houseofnorth/neonfade/Neonfade v422 bottom.png

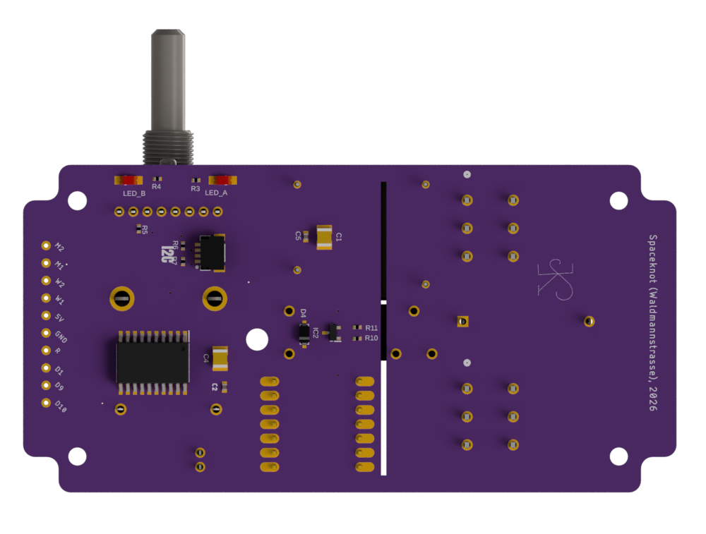
Neonfade v422 bottom.png
