houseofnorth/neonfade/Specs/ALPS-RK168-100KBX2-Pinout.jpg

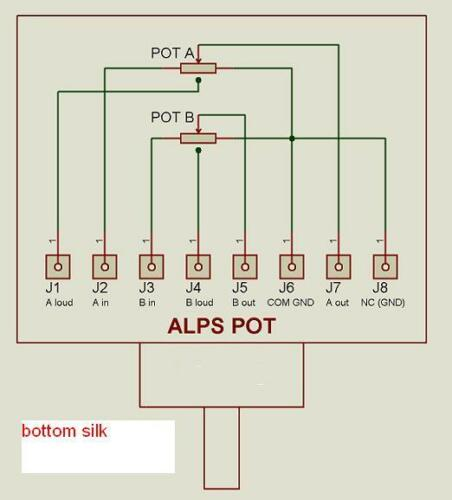
Specs/ALPS-RK168-100KBX2-Pinout.jpg
