houseofnorth/neonfade/Specs/XIAO ESP32 C3 Pin Map.png

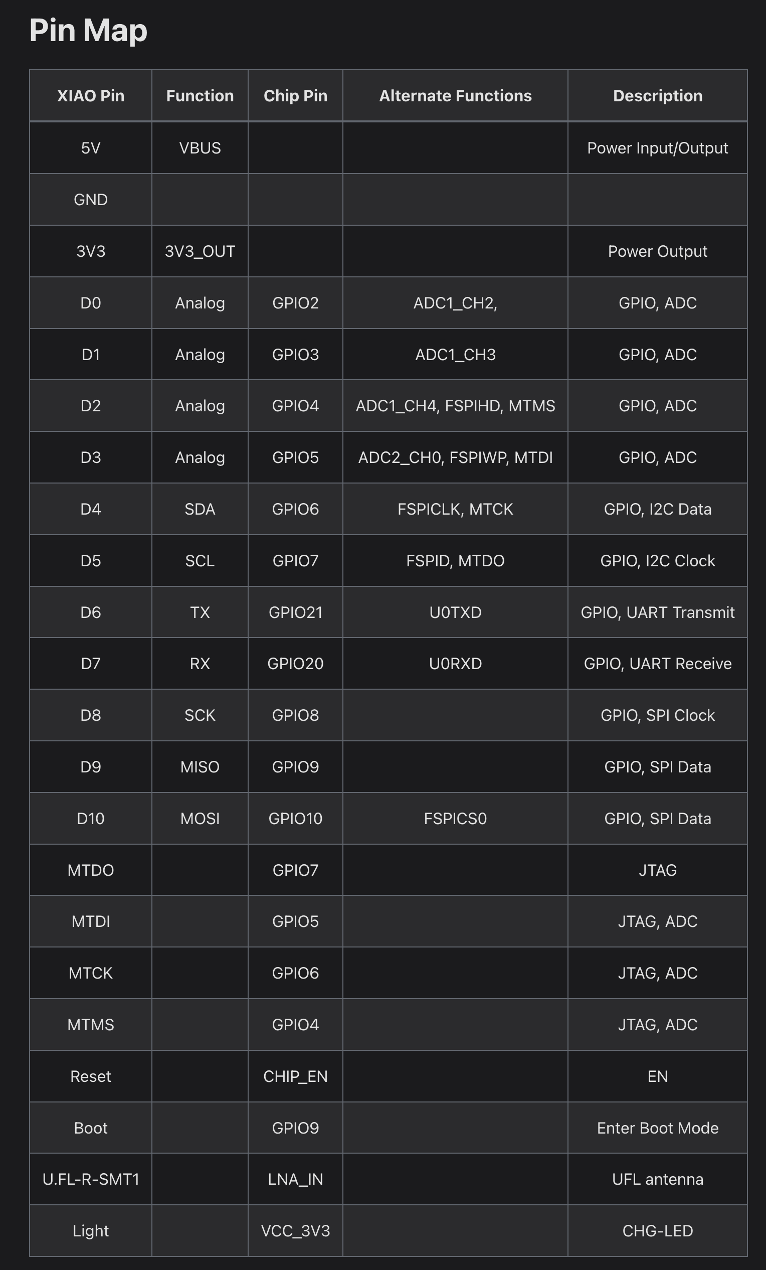
Specs/XIAO ESP32 C3 Pin Map.png
