houseofnorth/neonfade/Neon_Fader_V2_v376.sch

## EAGLE design Neon_Fader_V2_v376.sch (2026-05-29)

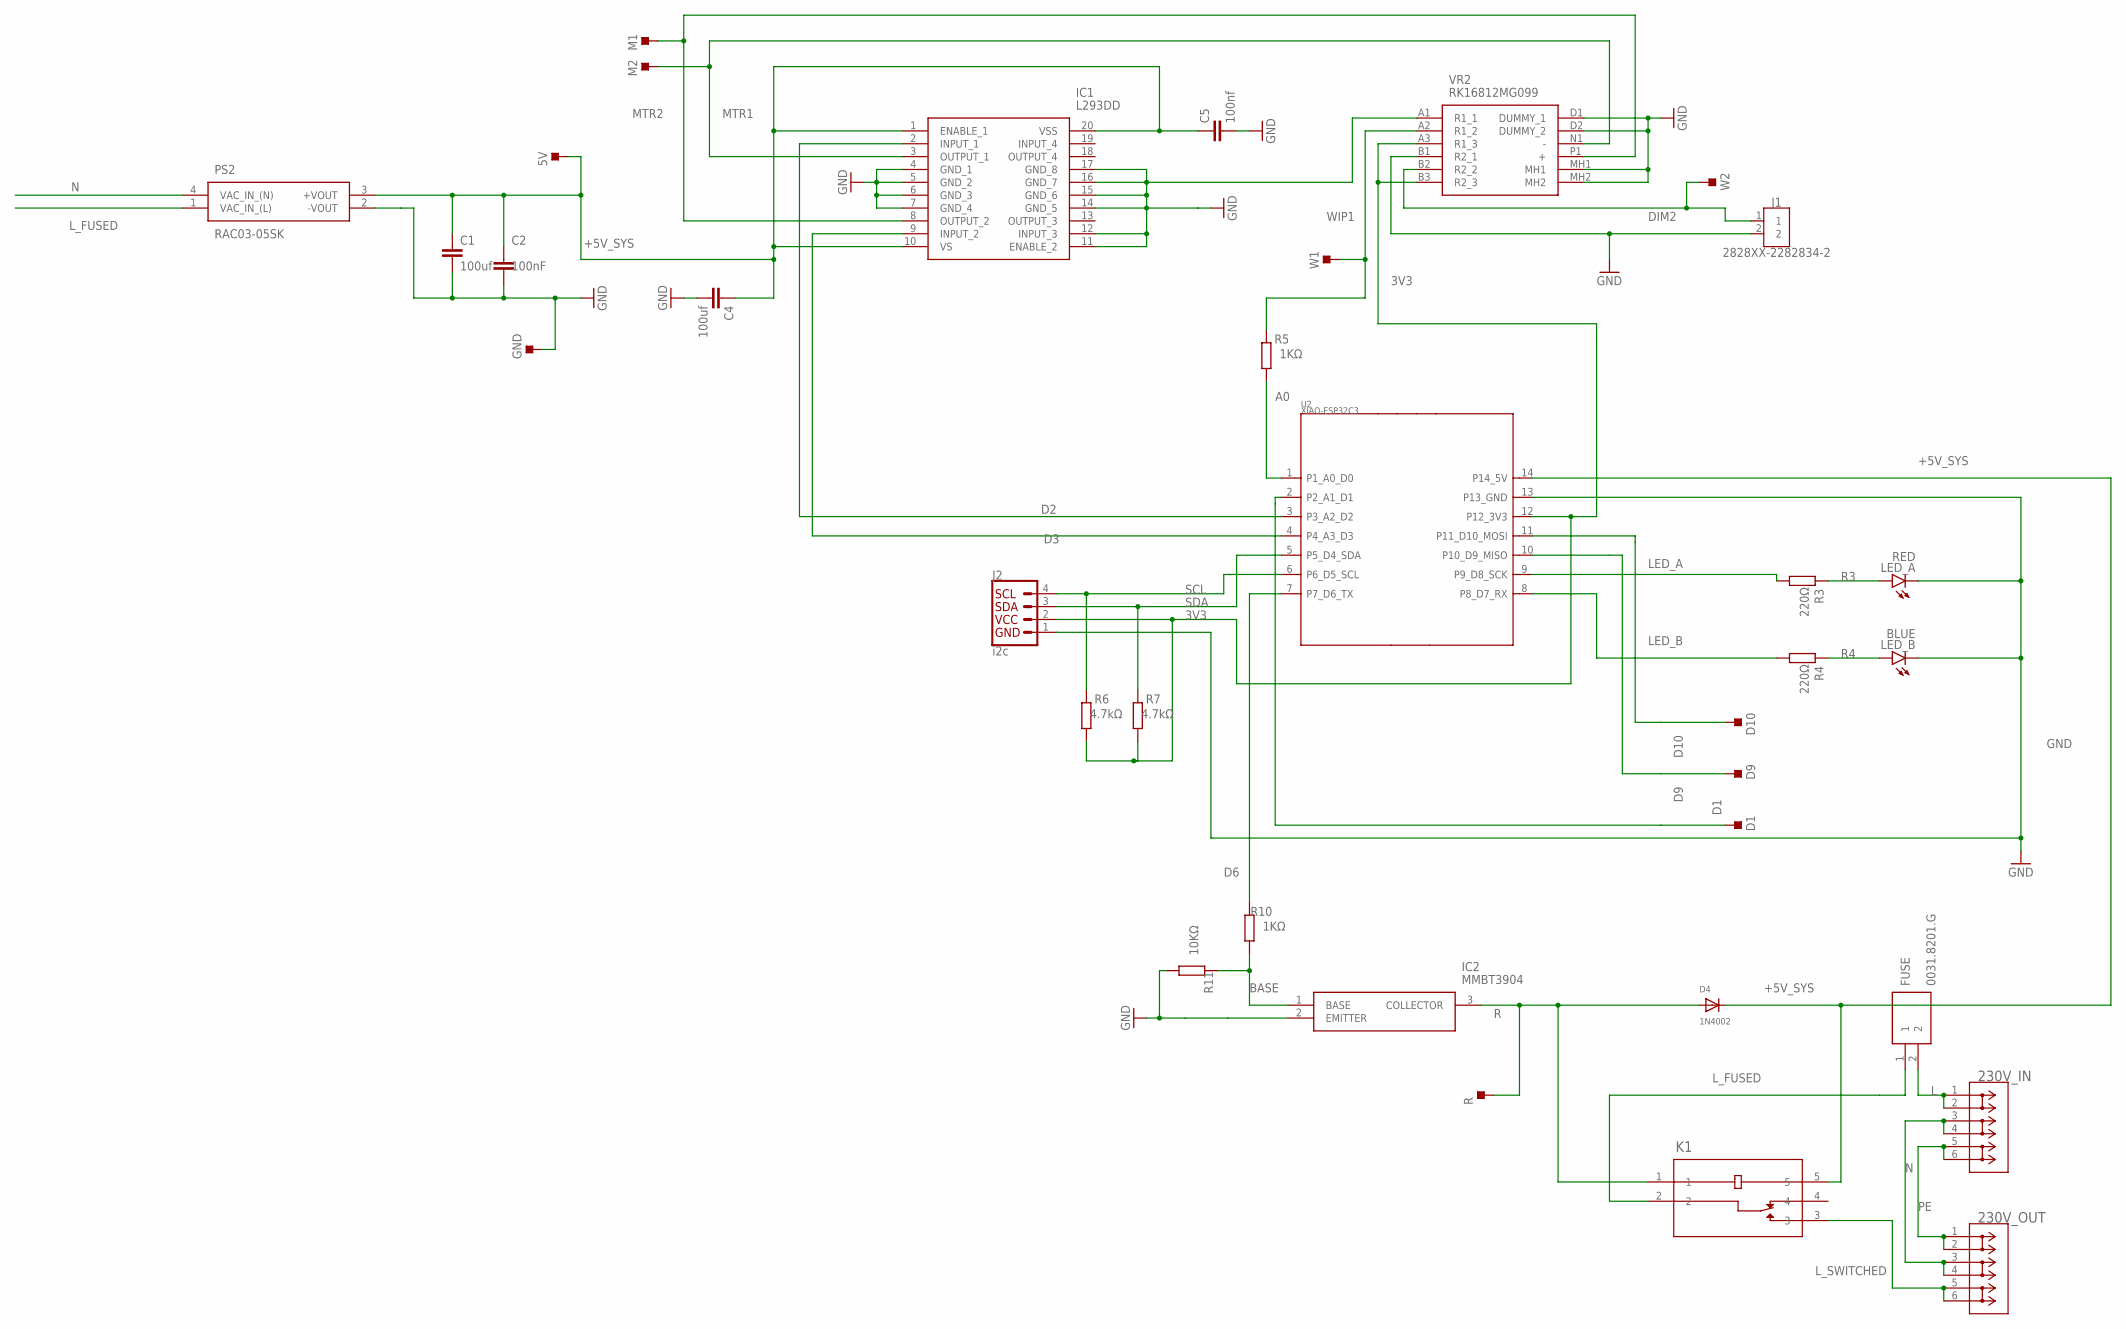
[picture p5: schematic Neon_Fader_V2_v376.sch]

Parts:
5V: TESTPOINT_TPS-PAD-036; TESTPOINT_PAD-036
230V_IN, 230V_OUT: 2604-1103CONN3_2604-1103_WAG; CONN3_2604-1103_WAG
C1, C4: 100uf; C1210
C2: 100nF; C0402
C5: 100nf; C0402
D1, D9, D10: TESTPOINT_TPS-PAD-036; TESTPOINT_PAD-036
D4: 1N4002; SOD-123
FUSE: 0031.8201.G; 00318201G
GND: TESTPOINT_TPS-PAD-036; TESTPOINT_PAD-036
IC1: L293DD; SOIC127P1032X265-20N
IC2: MMBT3904; SOT95P240X110-3N
J1: 2828XX-2282834-2; TERMBLK_254-2N
J2: i2c; 1X04_1MM_RA
K1: G6RN-1_DC5RELAY_G6RN-1_OMR; RELAY_G6RN-1_OMR
LED_A: RED; CHIPLED_1206
LED_B: BLUE; CHIPLED_1206
M1, M2: TESTPOINT_TPS-PAD-036; TESTPOINT_PAD-036
PS2: RAC03-05SK; RAC0305SK
R: TESTPOINT_TPS-PAD-036; TESTPOINT_PAD-036
R3, R4: 220Ω; R0402
R5, R10: 1KΩ; R0402
R6, R7: 4.7kΩ; R0402
R11: 10KΩ; R0402
U2: XIAO-ESP32C3; XIAO-GENERIC-HYBRID-MODULE14P-2.54-21X17.8MM
VR2: RK16812MG099
W1, W2: TESTPOINT_TPS-PAD-036; TESTPOINT_PAD-036

Connections:
3V3: J2.2 (VCC), R6.1, R7.1, U2.12 (P12_3V3), VR2.A3 (R1_3), VR2.B3 (R2_3)
+5V_SYS: 5V.1, C1.1, C2.1, C4.1, C5.1, D4.C, IC1.1 (ENABLE_1), IC1.10 (VS), IC1.20 (VSS), K1.5, PS2.3 (+VOUT), U2.14 (P14_5V)
A0: R5.1, U2.1 (P1_A0_D0)
BASE: IC2.1 (BASE), R10.1, R11.2
D1: D1.1, U2.2 (P2_A1_D1)
D2: IC1.2 (INPUT_1), U2.3 (P3_A2_D2)
D3: IC1.9 (INPUT_2), U2.4 (P4_A3_D3)
D6: R10.2, U2.7 (P7_D6_TX)
D9: D9.1, U2.10 (P10_D9_MISO)
D10: D10.1, U2.11 (P11_D10_MOSI)
DIM2: J1.1, VR2.B2 (R2_2), W2.1
GND: C1.2, C2.2, C4.2, C5.2, GND.1, IC1.4 (GND_1), IC1.5 (GND_2), IC1.6 (GND_3), IC1.7 (GND_4), IC1.11 (ENABLE_2), IC1.12 (INPUT_3), IC1.14 (GND_5), IC1.15 (GND_6), IC1.16 (GND_7), IC1.17 (GND_8), IC2.2 (EMITTER), J1.2, J2.1 (GND), LED_A.C, LED_B.C, PS2.2 (-VOUT), R11.1, U2.13 (P13_GND), VR2.A1 (R1_1), VR2.B1 (R2_1), VR2.D1 (DUMMY_1), VR2.D2 (DUMMY_2), VR2.MH1, VR2.MH2
L: 230V_IN.1 (1_1), 230V_IN.2 (1_2), FUSE.2
LED_A: R3.1, U2.9 (P9_D8_SCK)
LED_B: R4.1, U2.8 (P8_D7_RX)
L_FUSED: FUSE.1, K1.2, PS2.1 (VAC_IN_(L))
L_SWITCHED: 230V_OUT.5 (3_1), 230V_OUT.6 (3_2), K1.3
MTR1: IC1.3 (OUTPUT_1), M2.1, VR2.N1 (-)
MTR2: IC1.8 (OUTPUT_2), M1.1, VR2.P1 (+)
N: 230V_IN.3 (2_1), 230V_IN.4 (2_2), 230V_OUT.3 (2_1), 230V_OUT.4 (2_2), PS2.4 (VAC_IN_(N))
PE: 230V_IN.5 (3_1), 230V_IN.6 (3_2), 230V_OUT.1 (1_1), 230V_OUT.2 (1_2)
R: D4.A, IC2.3 (COLLECTOR), K1.1, R.1
R3: LED_A.A, R3.2
R4: LED_B.A, R4.2
SCL: J2.4 (SCL), R6.2, U2.6 (P6_D5_SCL)
SDA: J2.3 (SDA), R7.2, U2.5 (P5_D4_SDA)
WIP1: R5.2, VR2.A2 (R1_2), W1.1
