houseofnorth/neonfade/Firmware/ShellyButtonTest/shelly_button.ino

// ── DEPRECATED: Polling Button Reader ─────────────────────────────────────
//  This file is kept for reference only. The new webhook-based approach
//  (webhook.ino) is used instead. This provides instant event-driven input
//  without constant polling.
//
//  The functions below are now implemented in webhook.ino with the same
//  signatures for compatibility.

// (All functionality moved to webhook.ino)
