houseofnorth/neonfade/(commit log)

2026-05-29 Spaceknot v2.0.24 — full firmware restructure
    [Neon_Fader_V2_v376.sch, XIAO-ESP32C3-pinout_sheet.xlsx]
2026-05-29 Reorganise: archive old firmware versions
    [XIAO-ESP32C3-pinout_sheet.xlsx]
2026-05-29 v2.0.24 — rename to Spaceknot_v224, add router backup, releases folder
2026-05-31 v2.0.27 — cal motor drive, flush avg on capture, MQTT value sync
    - Motor drive buttons (FWD/REV hold-to-run) in cal panel so pot reaches hard stops
    - Live ADC bar + raw value readout during calibration
    - Flush rolling average buffer on Capture MIN/MAX for accurate single-press capture
    - Removed CALIB_MIN_RANGE validation — any range now saves
    - MQTT cal sync now broadcasts ADC values (min:NNN, max:NNN, capDay:NNN etc.)
    so all units receive identical calibration numbers
    - OTA password set to 'spaceknot'
    - Spaceknot_v224 moved to Archive; Spaceknot_v227 is now active
    - releases/Spaceknot_v227.ino.bin added
    - README updated: v227 refs, cal flow, MQTT format, OTA password
