houseofnorth/neonfade/(notices)

Notices in the files:
parts and their libraries:
SparkFun-Connectors: Licensing: Creative Commons ShareAlike 4.0 International - https://creativecommons.org/licenses/by-sa/4.0
G6RN-1 DC5 lib: COPYRIGHT: Copyright (C) 2026 Ultra Librarian. All rights reserved.
